drmcnelson/Instrumentation-Controller-T4.0-Rev3/README.md

# Instrumentation-Controller-T4.0-Rev3
Instrumentation Controller/carrier for Teens 4.0, with power panagement, keyed connectors for CCD (SPI+FlexPWM), SPI, DIO, diode protected analog inputs, and precision 2.048 voltage reference.

<p align="center">
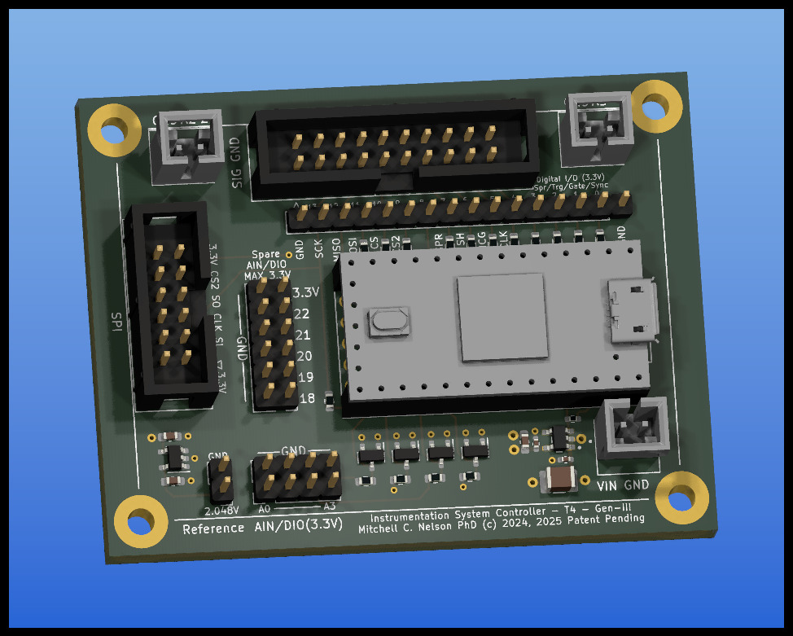
[picture p1: Images/Controller_T4_R3_top.jpg]
&nbsp;
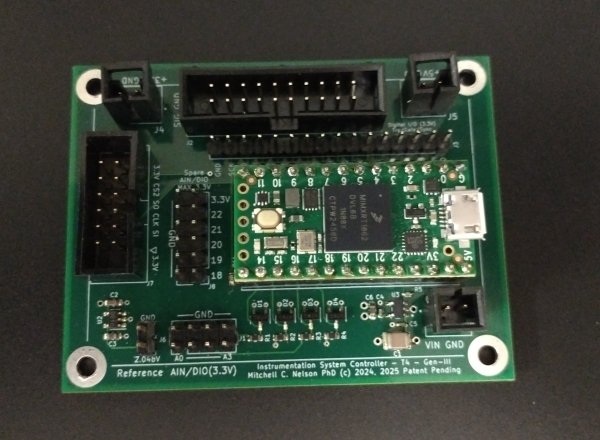
[picture p2: Images/Controller_T4_R3_photo_p600.jpg]

</p>

This repo provides gerbers for the updated controller for the SPI instrumentation project.  This update allows you to control peripherals with both SPI and precisely timed clock signals generated by the Teensy 4.0's FlexPWM module, and it also provides power management with current limiting for +5V power.  You need this specific controller for the latest version CCD sensor devices, and this will be the standard for the SPI instrumentation project going forward.

The interconnects can be seen in the image of the layout below.
The 20 pin keyed connector (J2) provides and interface for instrumentation boards that require SPI and precisely clocked control signals such as the [TCD1304 with linear reproducible response](https://github.com/drmcnelson/TCD1304-Sensor-Device-with-Linear-Response-and-16-Bit-Differential-ADC).  This connector carries the first SPI, with pin 10 for CS, plus 4 signal pins - pin 7, the three "A" outputs from FlexPWM2 Submodules 0 through 2 (pins 4 through 6), plus two pins for 3.3V power. The second row is ground.
The single row connector just below (J3), duplicates the top row of digital i/o pins from the Teensy 4.0.
The keyed 12 pin connector on the left (J7) carries SPI0 with pin 9 as CS.
The double row header adjacent to it (J8), carries digital i/o pins 18 through 22 plus 3.3V and the second row is ground.
The double row 8 pin header (J1) are analog inputs A0 through A3 and ground.
The two pin header (J6) is the 2.048V precision voltage reference.

The power output connector at the top right (J5) is +5V controlled by a USB compatible current limit switch.  Peripheral boards that require +5V should connect here, and especially so if they have inductive power filtering. 
The power output connector at the top left (J4) is +3.3V from the onboard LDO voltage regulator of the Teensy 4.0.
The power output at the lower right (J9) is a direct connection to the USB 5V line through the Teensy 4.0.

<p align="center">
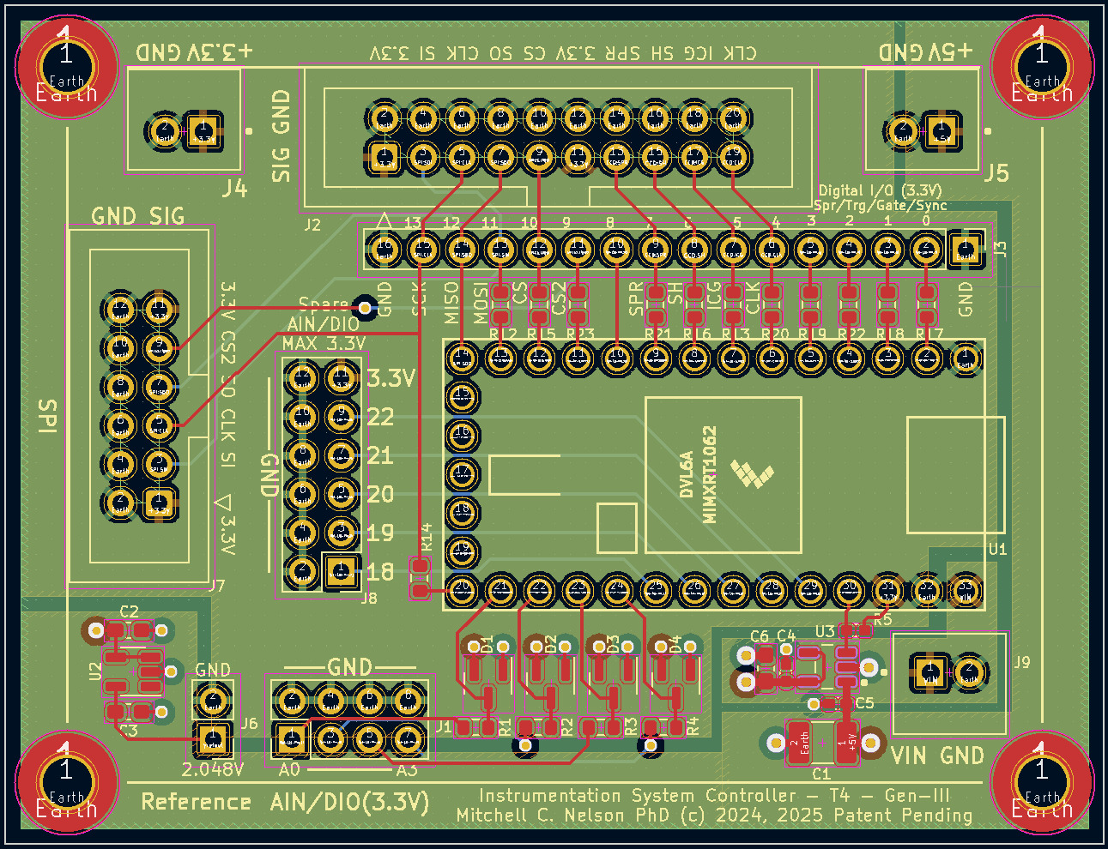
[picture p3: Images/Layout1.jpg]

</p>

Please be sure to see our other repos for instrumentation circuits and software.  And please do click the support button.  Your donation helps support open instruments for open science.

For questions, please contact me by direct message or email.
