drmcnelson/Instrumentation-Controller-T4.0-Rev3/Images/Layout2.jpg

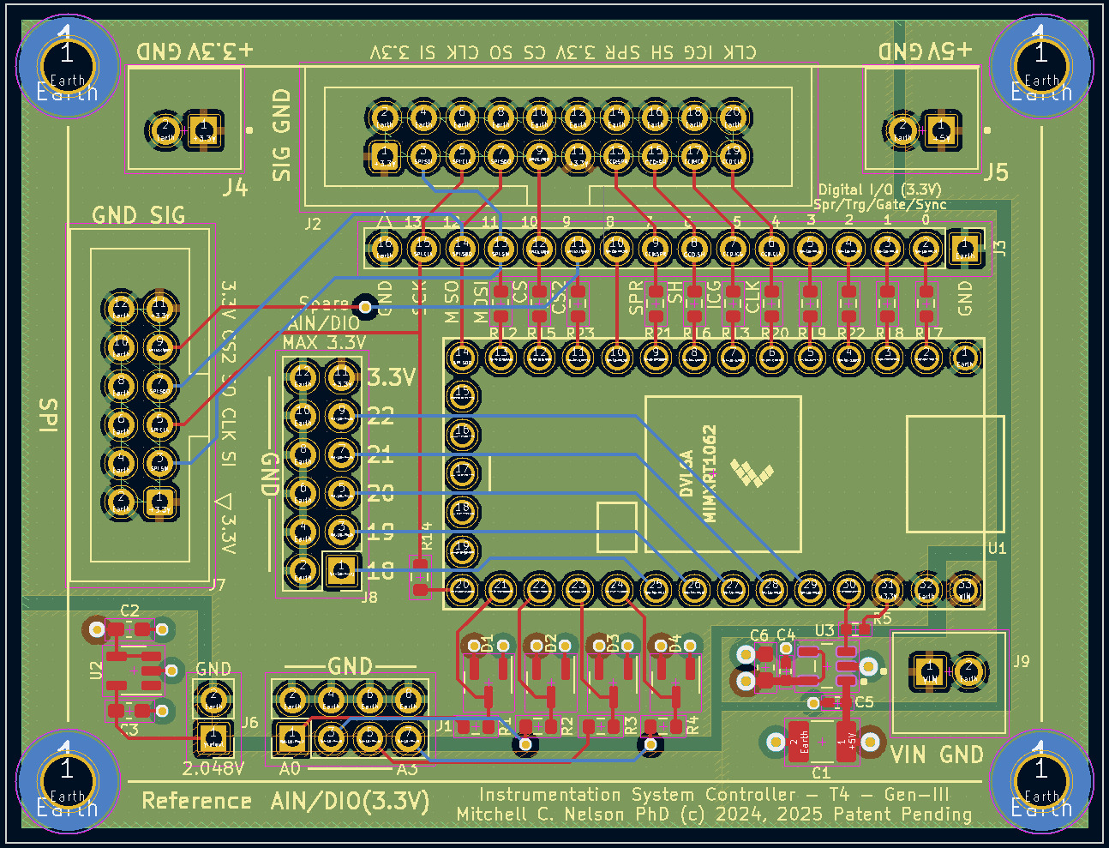
Images/Layout2.jpg
