drmcnelson/Instrumentation-Controller-T4.0-Rev3/Controller_T4_R3_BOM.xls

Reference | Value | Footprint | Qty | DNP | Description | Digikey
C1 | 22uf | Capacitor_SMD:C_1210_3225Metric_Pad1.33x2.70mm_HandSolder | 1 |  | Cap Cer 22uF, 10%, 25V, X5R | 399-C1210C226K3RACTUCT-ND
C2 | 10u | Capacitor_SMD:C_0603_1608Metric_Pad1.08x0.95mm_HandSolder | 1 |  | Cer Cap 10uF 10% 16V, X5R | 490-12317-1-ND
C3,C6 | 1uF | Capacitor_SMD:C_0603_1608Metric_Pad1.08x0.95mm_HandSolder | 2 |  | CAP CER 1UF 25V X7R 0603 | 399-C0603C105K3RACTUCT-ND
C4,C5 | 0.1uF | Capacitor_SMD:C_0402_1005Metric_Pad0.74x0.62mm_HandSolder | 2 |  | CAP CER 0.1UF 50V X7R 0402 | 1276-CL05B104KB54PNCCT-ND
D1,D2,D3,D4 | BAV99 | Package_TO_SOT_SMD:SOT-23 | 4 |  | DIODE ARR GP 100V 215MA TO236AB | 1727-2914-1-ND
J1 | Conn_02x04_Odd_Even | Connector_PinHeader_2.54mm:PinHeader_2x04_P2.54mm_Vertical | 1 |  | Generic connector, double row, 02x04, odd/even pin numbering scheme (row 1 odd numbers, row 2 even numbers), script generated (kicad-library-utils/schlib/autogen/connector/) | 3M156307-08-ND | can cut from 3M156307-72-ND
J2 | Conn_02x10_Odd_Even | Connector_IDC:IDC-Header_2x10_P2.54mm_Vertical | 1 |  | CONN HEADER VERT 20POS 2.54MM | ED10524-ND
J3 | Conn_01x16_Male | Connector_PinHeader_2.54mm:PinHeader_1x16_P2.54mm_Vertical | 1 |  | CONN HEADER VERT 16POS 2.54MM | 3M156268-16-ND | can cut from 3M156268-36-ND
J4,J5,J9 | 705430001 | MOLEX_705430001 | 3 |  | CONN HEADER VERT 2POS 2.54MM | WM4800-ND
J6 | Conn_01x02_Male | Connector_PinHeader_2.54mm:PinHeader_1x02_P2.54mm_Vertical | 1 |  | CONN HEADER VERT 2POS 2.54MM | 3M156268-02-ND | can cut from 3M156268-36-ND
J7 | Conn_02x06_Odd_Even | Connector_IDC:IDC-Header_2x06_P2.54mm_Vertical | 1 |  | Generic connector, double row, 02x06, odd/even pin numbering scheme (row 1 odd numbers, row 2 even numbers), script generated (kicad-library-utils/schlib/autogen/connector/) | 23-0702461201-ND
J8 | Conn_02x06_Odd_Even | Connector_PinHeader_2.54mm:PinHeader_2x06_P2.54mm_Vertical | 1 |  | Generic connector, double row, 02x06, odd/even pin numbering scheme (row 1 odd numbers, row 2 even numbers), script generated (kicad-library-utils/schlib/autogen/connector/) | 3M156307-12-ND | can cut from 3M156307-72-ND
R1,R2,R3,R4 | 100R | Resistor_SMD:R_0603_1608Metric | 4 |  | RES SMD 100 OHM 1% 1/4W 0603 | 10-ERJ-UP3F1000VCT-ND
R5 | 10K | Resistor_SMD:R_0402_1005Metric_Pad0.72x0.64mm_HandSolder | 1 |  | RES SMD 10K OHM 1% 1/10W 0402 | P10.0KLCT-ND
R12,R13,R14,R15,R16,R17,R18,R19,R20,R21,R22,R23 | 49.9 | Resistor_SMD:R_0603_1608Metric | 12 |  | RES 49.9 OHM 1% 1/10W 0603 | RMCF0603FT49R9CT-ND
U2 | LM4132xMF-2.0 | Package_TO_SOT_SMD:SOT-23-5 | 1 |  | IC VREF SERIES 0.1% SOT23-5 | LM4132BMF-2.0/NOPBCT-ND
U3 | TPS2065DBVR | TPS2065DBVR:SOT95P280X145-5N | 1 |  | Power Switch/Driver 1:1 N-Channel 1A SOT-23-5 | 296-39354-1-ND
Hand Assembly
U1 | Teensy4.0 | teensy_footprints:Teensy40 | 1 |  | Teensy4.0 | 1568-DEV-16997-ND | Sensitive!!!
Sockets | Teensy4 socket |  | 2 |  | CONN HDR 14POS 0.1 GOLD PCB | S7047-ND | Make sure headers are vertical, confirm mechanical fit and able to install the Teensy.
