drmcnelson/Instrumentation-Controller-T4.0-Rev3/Controller_T4_R3EB.step

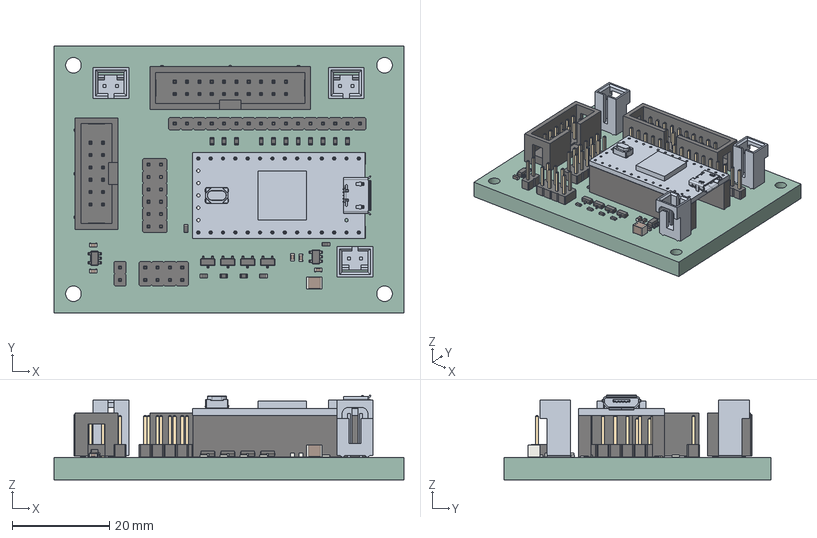
[picture p5: CAD file, 2026-05-04]
Controller_T4_R3EB.step
72.0 x 55.0 x 17.4 mm
PinHeader_2x06_P2.54mm_Vertical
SOT-23 x 4
R_0603_1608Metric x 17
SOT-23-5 x 2
C_1210_3225Metric
PinHeader_1x16_P2.54mm_Vertical
C_0603_1608Metric x 5
Teensy_4.0_PCB
Micro USB-B Female 5Pin SMD
NXP iMXRT1062
SKRPACE010 v4
PinSocket_1x14_P2.54mm_Vertical x 2
PinHeader_2x04_P2.54mm_Vertical
PinHeader_1x02_P2.54mm_Vertical
IDC-Header_2x10_P2.54mm_Vertical
IDC-Header_2x06_P2.54mm_Vertical
Controller_T4_R3EB_PCB
