drmcnelson/Instrumentation-Controller-T4.0-Rev3/Controller_T4_R3.pdf

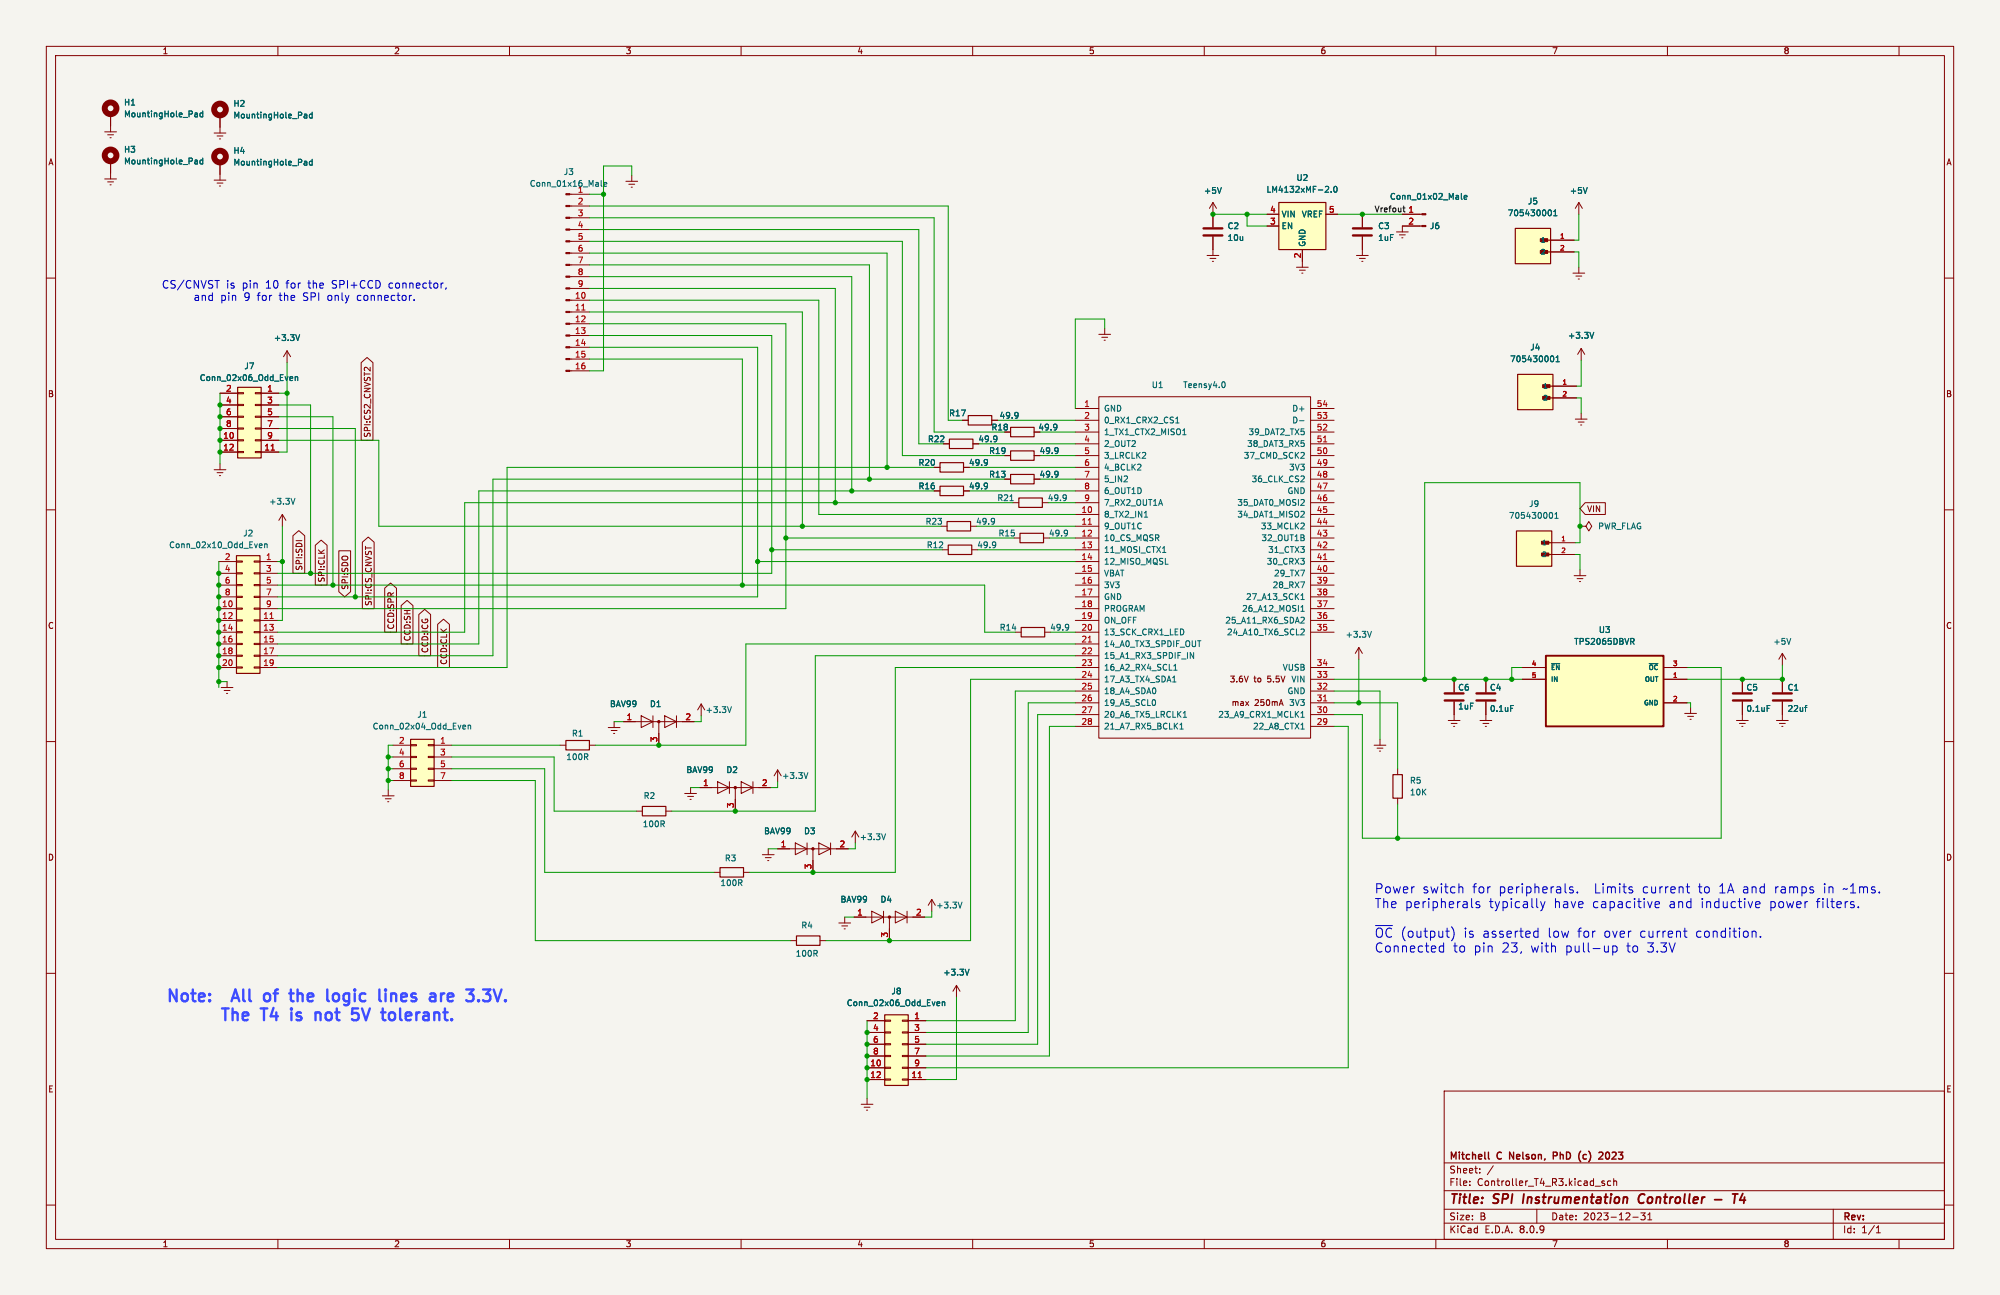
[picture p6: page 1]

CS/CNVST is pin 10 for the SPI+CCD connector,

VIN SPI:CS_CNVST SPI:SDO

The T4 is not 5V tolerant.
